triton-droids/cse-145-237d-tactile-hands/final paper/main.tex

\documentclass[acmlarge,screen,nonacm]{acmart}

% --- packages not already loaded by acmart ---
\usepackage{tabularx}

% suppress the ACM reference block (also implied by nonacm)
\settopmatter{printacmref=false}
\setlength{\footskip}{12pt}

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

%=====================================================================
\begin{document}

\title{Tactile Hands: A Force-Sensing Robotic Hand for Safe Grasping}

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

\renewcommand{\shortauthors}{Triton Droids: Tactile Hands}

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

\keywords{tactile sensing, force-sensing resistors, robotic hand, grasping,
calibration, teleoperation, ROS~2, low-cost robotics}

\maketitle

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

Why is this capability missing at low cost? High-fidelity tactile sensors are
expensive (Section~\ref{sec:related}), whereas force-sensing resistors (FSRs)
cost a few dollars each, need a single analog channel, and add no per-finger
compute. Their drawback is
signal quality: FSRs are nonlinear, hysteretic, and vary unit to unit, so a raw
reading is not a force. We treated this as an engineering problem rather than a
fundamental limit. With a controlled calibration procedure and a simple
per-sensor model, inexpensive FSRs can be made accurate enough (better than
1~N) to close a useful safety loop, which is all that grasping a fragile object
without crushing it actually requires.

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

Beyond the core force-sensing minimum viable product (MVP), we built three
input and simulation extensions that share the same ROS~2 backbone: a
webcam-based hand-pose pipeline that mirrors a human operator's finger curl onto
the hand, a physics simulation of the AmazingHand for kinematics validation and
future sim-to-real work, and a virtual-reality (VR) teleoperation pipeline that
streams 6-DoF controller pose into ROS~2. Most recently, we mounted the hand on
an open-source ARCTOS robotic arm~\cite{arctos2024} and teleoperated its
end-effector from VR controllers (Section~\ref{sec:teleopgrasp}). We
further added vision-guided, multi-object grip selection: a fine-tuned YOLO26
object detector recognizes the target object in a webcam image and selects an
appropriate per-object grip force automatically.

\paragraph{Contributions.} This paper makes the following contributions:
\begin{itemize}
  \item A \textbf{sub-\$200, open hardware design} that adds fingertip force
        sensing to a low-cost, 3D-printable robotic hand, including a custom
        ESP32-S3 sensing board with per-channel voltage dividers.
  \item A \textbf{repeatable FSR calibration procedure} using stacked 3D-printed
        reference weights and a power-law fit that maps raw ADC counts to force
        with better-than-1~N accuracy (max error 25.7~g $\approx$ 0.25~N).
  \item A \textbf{force-aware grasp controller} on a ROS~2 host that fuses the
        calibrated fingertip forces with finger position commands to grasp and
        release a fragile object without crushing it.
  \item A \textbf{teleoperation demonstration of the force-aware safety}: using VR control of the arm-mounted hand, force-thresholded
        grasping holds a fragile cup that an otherwise-identical force-blind
        grasp visibly collapses, showing the contribution of the tactile
        feedback.
  \item A set of \textbf{teleoperation and simulation extensions}
        (webcam hand-pose mirroring, physics simulation, and VR controller
        streaming) that share one ROS~2 interface, culminating in a
        VR-teleoperated, arm-mounted hand and a vision-guided, multi-object
        grip-selection pipeline driven by a fine-tuned YOLO26 detector.
\end{itemize}

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

%=====================================================================
\section{Technical Material}
\label{sec:technical}
%=====================================================================

\subsection{System Architecture}
The system is a sensing-and-actuation hand connected to a ROS~2 host. On the
hand, an ESP32-S3 reads four FSRs through voltage dividers and streams
calibrated forces over USB; on the host, a serial-bridge node publishes those
forces and forwards servo commands back. Every input subsystem (hand-pose
estimation, VR streaming, simulation) produces target finger or end-effector
commands, and the force-aware grasp controller decides to allow commanded
motion only while fingertip forces stay below a safe limit
(Figure~\ref{fig:block}).

\begin{figure}[htbp]
\centering

\caption{Force-aware grasp control loop. Target finger positions and live FSR
forces are constantly compared. If a finger's force exceeds the threshold,
motion is restricted and a red status LED lights; otherwise the servo command
is issued.}
\label{fig:block}
\end{figure}

\subsection{Mechanical Platform}
The hand is based on the open-source AmazingHand~\cite{pollen2025amazinghand}, a
four-fingered, fully 3D-printed design. Each finger is actuated by two Feetech
SCS0009 serial-bus micro servos (eight in total), giving four independently
controllable fingers.
We kept the original four-finger morphology, which is sufficient for force-aware
power and pinch grasps on our test objects and keeps the hand compact enough to
mount on a small arm. The fingertips were modified to host an FSR pad and to
route its leads back toward the palm (Figure~\ref{fig:mvphand}, left). The entire hand,
prototype board, and status LEDs are enclosed in a 3D-printed shell printed on
a Bambu Lab A1~Mini, with the electronics mounted on the back of the hand
(Figure~\ref{fig:enclosure}).

\begin{figure}[htbp]
\centering
\hspace{0.03\linewidth}

\caption{The Tactile Hand. Left: assembled on its base, with a force-sensing
resistor bonded to each fingertip and its leads routed back toward the palm.
Right: performing a force-aware grasp of a thin-walled cup, halting finger
closure the moment the measured fingertip force exceeds the safe threshold
(Section~\ref{sec:graspctl}).}
\label{fig:mvphand}
\end{figure}

\subsection{Sensing Electronics}
Each fingertip carries a Pololu \#2728 FSR. Because an FSR behaves as a
force-dependent variable resistor, we read it with a simple voltage divider: the
FSR is placed in series with a fixed reference resistor $R_\mathrm{ref}=48\,
\mathrm{k}\Omega$, and the ESP32-S3's 12-bit ADC samples the divider's midpoint,
$V_\mathrm{adc} = V_\mathrm{cc}\,R_\mathrm{ref}/(R_\mathrm{FSR}(F) +
R_\mathrm{ref})$. As applied force $F$ increases, $R_\mathrm{FSR}$ falls and
$V_\mathrm{adc}$ rises toward $V_\mathrm{cc}$; the ADC reports a raw count
$r \in [0, 4095]$. We use the ESP32-S3 for sending the data back to the host. The board is a protoboard hosting the
ESP32-S3, the four voltage dividers, and vertical 0.1-inch (2.54~mm) headers
for the FSR Dupont leads. Power comes from a 2S LiPo (7.4~V nominal) stepped
down to 5~V by a buck converter.

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

\begin{figure}[htbp]
\centering

\caption{Force-sensor calibration. Left: the calibration rig, a 3D-printed
loading plate on the FSR's active area loaded with stacked PLA reference weights
to apply a known mass. Right: a power-law model fit to seven stacked-weight
loading points maps raw ADC counts to applied force, with worst-case error
25.7~g ($\approx$0.25~N), well within the 1~N target.}
\label{fig:calib}
\end{figure}

\subsection{Force-Aware Grasp Control}
\label{sec:graspctl}
The grasp controller (Figure~\ref{fig:block}) runs on the host at the sensor
rate. A finger is driven toward a target curl by an open-loop closing
trajectory (during MVP demos) or by a teleoperation input. At every cycle the
controller reads that finger's calibrated force from \texttt{/tactile/forces}.
While the force is below the safe threshold $\tau$, the commanded position is
forwarded to the servo and the finger continues to close. The instant the force
crosses $\tau$, the controller freezes that finger's target (the ``restrict
motion'' branch) so it stops squeezing harder even though the nominal trajectory would
keep closing, and a red status LED (one of two indicator LEDs on the board)
lights to signal that the threshold has been reached. Release is triggered on
demand by commanding the fingers open. In practice this lets the hand wrap a
thin-walled paper cup and halt at its safe limit without buckling the wall
(Figure~\ref{fig:mvphand}, right).

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

\subsection{Physics Simulation}
\label{sec:simsec}
We brought up the AmazingHand in the MuJoCo physics
simulator~\cite{todorov2012mujoco} by loading its
URDF/MJCF model and verifying that the simulated finger kinematics and curl
poses match the real hand. The simulation serves two
purposes: it is a safe sandbox for validating control logic before running it on
hardware, and it is the foundation for sim-to-real experiments. The main one is an
in-hand cube-rotation policy trained in simulation that we intend to
transfer to the real hand (Figure~\ref{fig:siminhand}, left), where the reality
gap~\cite{zhao2020sim2real} between simulated and physical FSR contact remains
the central challenge.

\begin{figure}[htbp]
\centering
\hspace{0.03\linewidth}

\caption{Left: simulated in-hand manipulation. The AmazingHand model grasps a
cube in MuJoCo, the environment used to develop the in-hand cube-rotation policy
we intend to transfer to hardware. Right: vision-guided grip selection. A
fine-tuned YOLO26 detector recognizes each object and its class (e.g., filled
vs.\ empty plastic bottle), and the detected class selects a per-object
grip-force threshold the force-aware loop enforces (Section~\ref{sec:multiobject}).}
\label{fig:siminhand}
\end{figure}

\subsection{VR Teleoperation and Arm Integration}
\label{sec:vr}
Our final input modality is VR teleoperation. We initially built a Meta Quest~2
APK in Unity 2022.3 LTS from the
\texttt{unity\_ros\_teleoperation} framework~\cite{leggedrobotics_teleop} and
successfully streamed 6-DoF controller pose (position and orientation) into
ROS~2 on Ubuntu. While functional, the Quest~2 path was awkward to integrate
with our Python-based control stack. We therefore switched to Valve
Index controllers, read through OpenVR/\texttt{pyopenvr}~\cite{valve2024openvr},
which gave us a clean pure-Python interface and native per-finger capacitive
tracking. With the Index controllers, controller pose is published as a ROS~2
topic at interactive rates. The same per-finger capacitive sensing lets the
operator's finger motion drive the hand's fingers directly
(Figure~\ref{fig:vrindex}, left), so a single controller supplies both the 6-DoF wrist
pose and a per-finger curl signal on the shared \texttt{/servo/commands}
interface.

\begin{figure}[htbp]
\centering
\hspace{0.02\linewidth}%

\caption{VR teleoperation. Left: the Valve Index controller's native capacitive
finger tracking is streamed over ROS~2 to drive the robotic hand's finger curl
directly from the operator's hand. Right: the controller's 6-DoF pose drives the
ARCTOS arm end-effector through our framework (frame calibration, IK, and motion
smoothing), giving VR control of the arm-mounted hand.}
\label{fig:vrindex}
\end{figure}

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

Our pipeline recognizes the target in a webcam frame with a fine-tuned
YOLO26 object detector~\cite{ultralytics_yolo26}. We annotated a small custom
dataset of our objects (e.g., filled plastic bottle, empty plastic
bottle, plastic box container, and book) and fine-tuned YOLO26 on
it, giving real-time bounding-box detections with a class label per object
(Figure~\ref{fig:siminhand}, right). Each class maps to a hand-tuned target grip
force, with heavier or sturdier objects getting a firmer threshold and lighter or
more fragile ones a gentler threshold, and the detected class selects which
threshold the force-aware loop enforces. The detector changes only the
source of the target force; the downstream \texttt{/tactile/forces}
feedback path and the restrict-motion logic of Section~\ref{sec:graspctl} are
reused unchanged, which kept the addition lightweight.

This experiment also exposes a calibration limitation: FSRs respond differently
to off-axis and shear loading than to the normal loading used during calibration
(Section~\ref{sec:calibration}), so a misaligned grip reads a biased force. We
have begun characterizing each sensor's off-axis response and feeding it back
into the physics simulation (Section~\ref{sec:simsec}) to tighten the sim-to-real
match.

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

\begin{table}[t]
\caption{Milestone status. All MVP-track items are complete; reach goals range
from complete to not completed, consistent with their deferred priority.}
\label{tab:milestones}
\small
\renewcommand{\arraystretch}{1.05}
\begin{tabularx}{\linewidth}{@{}Xll@{}}
\toprule
\textbf{Milestone} & \textbf{Target} & \textbf{Status} \\
\midrule
System design, board fabrication \& components & W2--W4 & Complete \\
Hand assembly, FSR integration \& firmware     & W3--W5 & Complete \\
FSR calibration to within 1~N                  & W4--W6 & Complete \\
Simulation bring-up of AmazingHand             & W3--W5 & Complete \\
Force-aware grasping closed loop               & W5--W6 & Complete \\
\textbf{MVP completion \& validation}          & \textbf{W6} & \textbf{Complete} \\
Hand-pose estimation pipeline (reach)          & W7--W9 & Complete \\
VR teleoperation: pose streaming, arm integration \& force-aware grasp (reach) & W7--W9 & Complete \\
Multi-object force awareness (reach)           & W8--W9 & Complete \\
Sim-to-real in-hand rotation (reach)           & W8--W9 & Not completed \\
Final paper, demo video, GitHub repo           & W9--W10 & In progress \\
\bottomrule
\end{tabularx}
\end{table}

\subsection{Mid-Quarter Revisions}
Our main mid-quarter revision was the VR hardware: we changed from the chartered
Meta Quest~2 to Valve Index controllers (Section~\ref{sec:vr}). We had a working
Quest~2 APK, but it was awkward to drive from our Python stack.

\subsection{What We Did and Did Not Finish}
All MVP deliverables were met, and the reach-goal outcomes are listed in
Table~\ref{tab:milestones}. Two items remain unfinished: the sim-to-real
transfer of the in-hand rotation policy (trained in simulation but not yet moved to hardware),
and finger adduction/abduction control (our curl interface captures flexion
only). Because reach goals were started only after the
Week~6 MVP, these gaps reflect the time available afterward, not a failure of the
core deliverable.

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

%=====================================================================
\bibliographystyle{ACM-Reference-Format}
\bibliography{references}

\end{document}
