triton-droids/cse-145-237d-tactile-hands/final paper/figures/arm_mounted.png

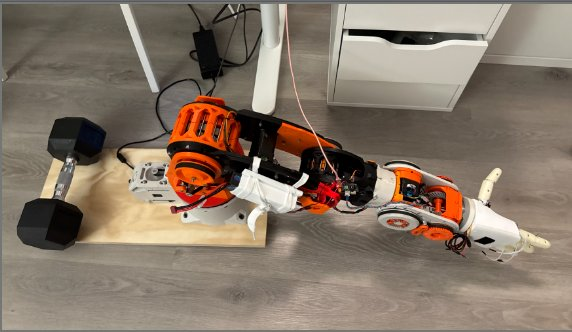
final paper/figures/arm_mounted.png
