triton-droids/cse-145-237d-tactile-hands/final paper/figures/open_hand.png

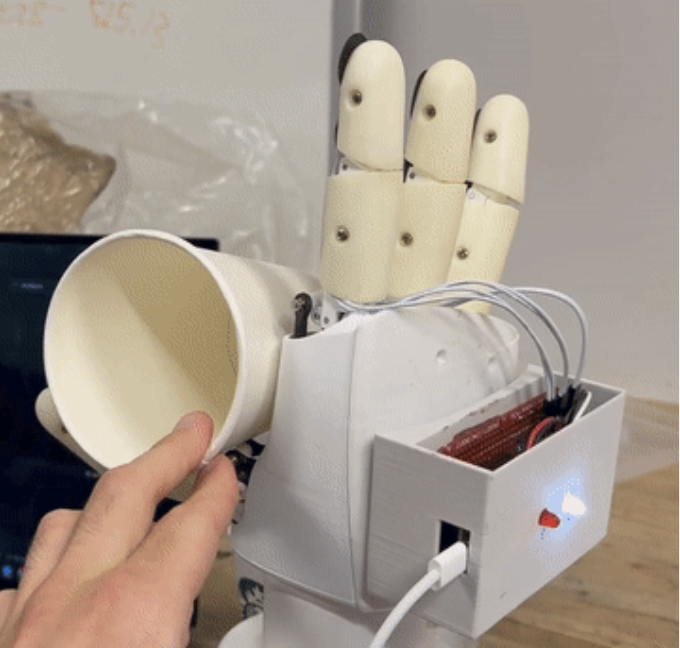
final paper/figures/open_hand.png
