triton-droids/cse-145-237d-tactile-hands/final paper/figures/sim.png

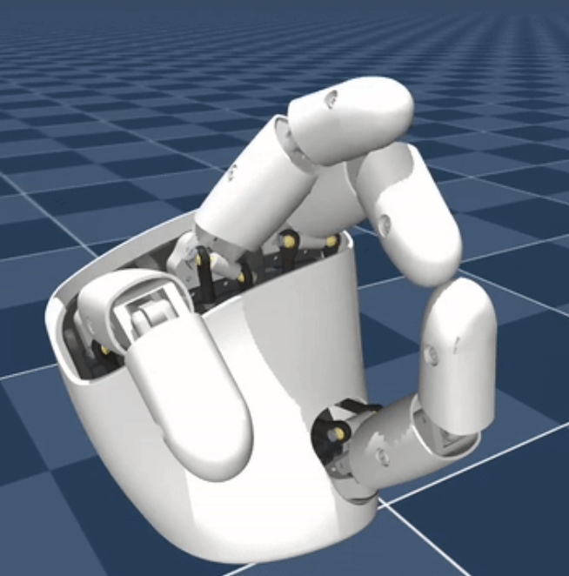
final paper/figures/sim.png
