triton-droids/cse-145-237d-tactile-hands/final paper/figures/teleop_noforce.png

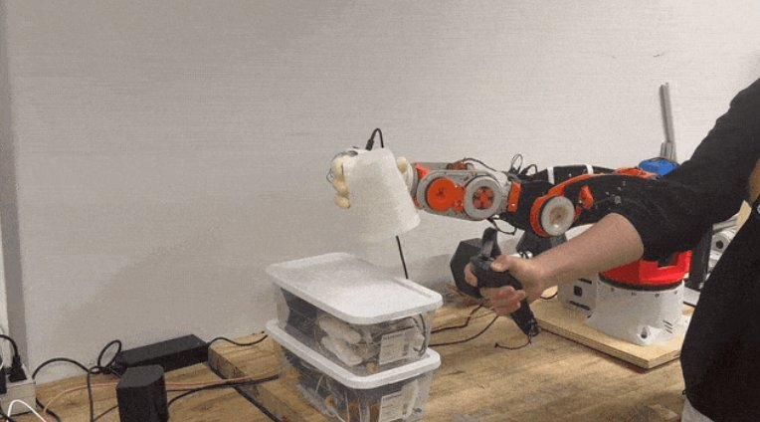
final paper/figures/teleop_noforce.png
