triton-droids/cse-145-237d-tactile-hands/hand_control/Mediapipe hand model.png

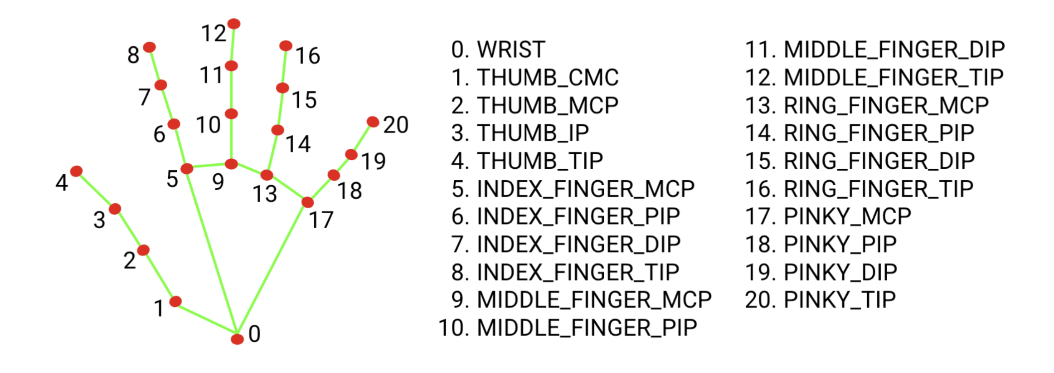
hand_control/Mediapipe hand model.png
