triton-droids/cse-145-237d-tactile-hands/fsr_calibration/FSR Calibration Plate.stl

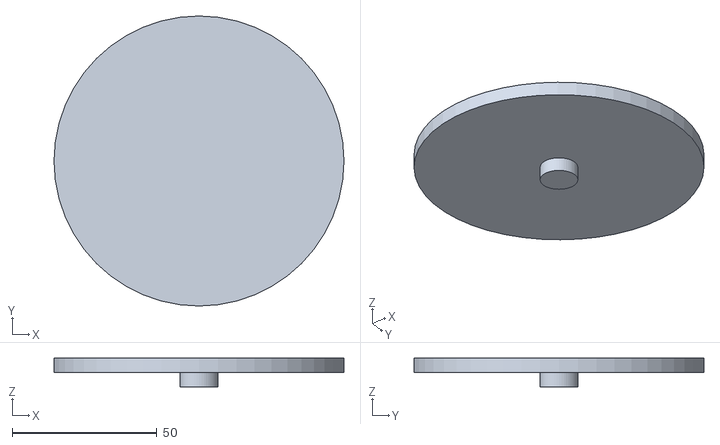
[picture p30: CAD file, 2026-05-09]
fsr_calibration/FSR Calibration Plate.stl
100.0 x 100.0 x 10.0
