triton-droids/cse-145-237d-tactile-hands/fsr_calibration/fsr_calibration.png

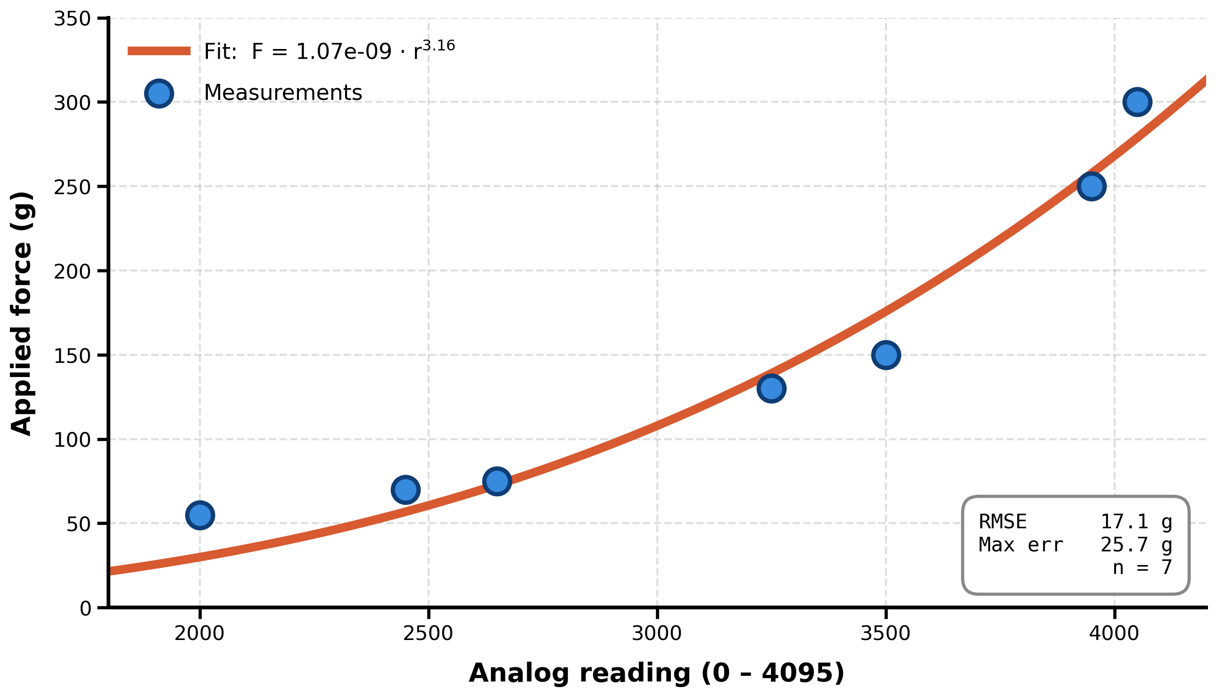
fsr_calibration/fsr_calibration.png
