triton-droids/cse-145-237d-tactile-hands/(commit log)

2026-05-04 force calibration slide
2026-05-09 Upload calibration plate
    [FSR Calibration Plate.stl]
2026-05-18 Add VR rotation teleop for ARCTOS J1 (velocity mode)
    - arctos_arm.py: add speed-mode primitive (0xF6) set_joint_speed/
    stop_joint; settle delay + retrying sync_all_encoders to fix
    first-frame-drop on connect; port autodetect skips legacy ttyS*
    and Valve/Watchman VR devices.
    - vr_teleop_rotation.py: deadman (hold-B) clutch; controller yaw
    offset from clutch-in -> J1 joint speed; open-loop + encoder-poll
    travel limit; graceful stop on release/exit.
    - teleop_actions.json / teleop_binding.json: minimal Index binding
    (hand_pose + clutch on B), no calibration.
    Hardware-verified on J1: connect, speed mode, direction, stop.
    [arctos_arm.py, vr_teleop_rotation.py]
2026-05-18 Switch VR teleop to position control (P-loop on speed mode)
    Controller yaw offset from clutch-in now maps to a J1 *target angle*
    (SCALE, default 1:1) instead of a speed. Implemented as a software
    P-loop on the hardware-verified 0xF6 speed mode: rpm = KP*(target -
    encoder), capped; settles in POS_DEADBAND_DEG. No 0xFE needed.
    Encoder feedback is now required — loop commands 0 if samples go
    stale (ENC_STALE_S) rather than drive blind. Faster encoder poll
    (0.08s). Target clamped to +/-MAX_TRAVEL_DEG of engage; hard runaway
    guard locks out if measured angle overshoots clamp + margin.
    Hardware-verified on J1: servos to +/-5 deg targets and back,
    settles within deadband, no overshoot.
    Co-Auth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
    [vr_teleop_rotation.py]
2026-05-18 Add J2 (shoulder) axis: controller vertical -> J2 position
    - Two-axis position teleop: J1<-controller yaw, J2<-controller
    height (room +Y). Generic per-axis config; encoder poller and
    P-loop now handle N joints; pose includes translation.
    - Per-joint rpm_floor + pos_deadband. J2 (loaded shoulder) has
    ~40 rpm break-away; KP*err alone stalls short of target, so
    nonzero commands are floored to rpm_floor (J2=45, J1=8).
    - Same B deadman clutch; engage refused unless ALL joints have a
    fresh encoder; runaway guard stops all joints.
    Hardware-verified J2: +rpm increases encoder (sign matches J1),
    P-loop converges to multiple targets both directions with no
    stall (residual within deadband).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
    [vr_teleop_rotation.py]
2026-05-18 Restructure VR teleop around a ROS publisher
    One OpenVR client (vr_controller_publisher.py) publishes the right
    controller pose + clutch on /vr/right_controller/pose (PoseStamped)
    and /vr/clutch (Bool). Teleop and visualizer are now ROS subscribers
    — no more dual-OpenVR concern.
    - vr_ros_io.py: shared transport + pose math + the AXES map (single
    source of truth). No openvr/python-can deps, so the visualizer
    stays arm-free. quat<->mat verified lossless; staleness tracking.
    - vr_teleop_rotation.py: drops OpenVR; consumes ROS; stale pose/
    clutch (publisher died / controller dropped) -> command 0.
    - vr_visualizer.py: consumes ROS instead of its own OpenVR.
    - run_vr_teleop.sh: sources RO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
2026-05-18 Fix: Ctrl+C ignored under ROS (arm + port left stuck)
    rclpy + the DDS layer install a SIGINT handler that swallowed Ctrl+C,
    so the teleop's finally never ran: arm not stopped, /dev/ttyACM0 left
    locked, process unkillable without SIGKILL. rclpy SignalHandlerOptions.NO
    alone was not enough (DDS still grabs it).
    - vr_ros_io: ros_init_no_signals(); ControllerSubscriber re-claims
    SIGINT+SIGTERM AFTER rclpy/DDS init (so ours wins), both raise
    KeyboardInterrupt into the main thread. Bounded executor shutdown
    so teardown can't hang.
    - publisher uses ros_init_no_signals() too.
    - teleop drops its now-redundant SIGTERM block.
    Verified: SIGINT and SIGTERM both -> clean exit ~0s with the
    subscrib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
    [vr_controller_publisher.py, vr_ros_io.py, vr_teleop_rotation.py]
2026-05-18 Faster 3D viz: persistent artists, FPS, axis swap
    - run_3d no longer ax.cla()+replot every frame. Artists created
    once; data updated via set_data/set_3d_properties. Recenter only
    near the cube edge (constant autoscale was the main slowdown).
    - --fps flag (default 30); live FPS shown in the info panel.
    - Backend guard: warn + fall back to text if matplotlib is on a
    non-interactive Agg backend (no window). Needs PyQt6 -> QtAgg.
    - Swap room Y<->Z in the plot so room-up (Y) is the vertical axis;
    labels/limits updated. Was confusing before.
    [vr_visualizer.py]
2026-05-18 Viz: fall back to text if Qt backend fails to start
    PyQt6 6.5+ needs system libxcb-cursor0 or the xcb plugin aborts the
    process. Realize the canvas early inside try/except and degrade to
    text mode with a clear apt hint instead of crashing the viz while
    teleop/publisher keep running.
    (install_vr_ros_deps.sh now apt-installs libxcb-cursor0 too.)
    [vr_visualizer.py]
2026-05-18 Fix yaw wrap discontinuity (atan2 +/-180 boundary)
    controller_yaw_deg wraps at +/-180; raw (yaw - yaw_ref) jumped ~360
    when crossing it, which the J1 P-loop turned into a slam. Add
    source_offset(): shortest signed difference for angular sources
    (SRC_WRAP), plain subtraction for linear (height). Used by teleop
    and visualizer so displayed target == commanded target.
    Verified: off(-179,179)=+2 (was -358); linear unchanged.
    [vr_ros_io.py, vr_teleop_rotation.py, vr_visualizer.py]
2026-05-18 Add One-Euro filter on the yaw source
    Yaw tracking had ~2deg jitter. Add a per-axis One-Euro filter
    (SourceFilter) on a continuous unwrapped signal so the +/-180 seam
    never enters the filter. Enabled for yaw (J1), off for height (J2).
    Filter runs every tick so it is warm at clutch-in; reference and
    live value both filtered -> no engage step.
    Sim (50Hz, +/-2deg noise): rest jitter 1.92->0.70 deg; during a
    30deg/s sweep noise 1.86->0.36 deg at ~89ms lag. Tunable via
    YAW_FILTER (mincutoff/beta).
    [vr_ros_io.py, vr_teleop_rotation.py]
2026-05-18 Publish Valve Index finger curls + trigger + grip
    Bring the capacitive finger-sensing path from the MuJoCo teleop into
    the ROS architecture so the AmazingHand driver can subscribe.
    - teleop_actions/binding.json: add skeleton_right (skeleton),
    trigger, grip actions + knuckles bindings.
    - publisher: read skeletal summary (VRSummaryType_FromAnimation),
    trigger, grip each tick; publish /vr/finger_curls
    (Float32MultiArray[5], FINGER_ORDER thumb,index,middle,ring,
    pinky; 0=open 1=closed), /vr/trigger, /vr/grip (Float32).
    Skeleton-missing fallback: curls = clip(trig + 0.5*grip), same
    as the MuJoCo teleop.
    - vr_ros_io: topic + FINGER_ORDER constants; HandSubscriber
    (background spin, s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
    [vr_controller_publisher.py, vr_ros_io.py]
2026-05-18 Port resolver: deterministically prefer the CANable
    The AmazingHand servo adapter (QinHeng 1A86 USB-serial) now shares the
    bus. Auto-detect took the first VID'd port, so it could grab the hand's
    tty for the arm (enumeration order is unstable). Add a CANable
    preference (VID 16D0 or canable/slcan/cantact/gs_usb in the descriptor)
    chosen ahead of any other usable port; warn + fall back otherwise.
    Verified with both plugged in: resolves /dev/ttyACM0 (CANable),
    skips /dev/ttyACM1 (hand).
    [arctos_arm.py]
2026-05-18 Add AmazingHand control node (ROS finger curls -> SCS servos)
    vr_hand_control.py: subscribes HandSubscriber, EMA-smooths the 5
    curls, maps to the 8 AmazingHand servos with the demo's differential
    open(-35/+35)/close(+90/-90) angles + per-servo MiddlePos, drives
    them via rustypot.
    Safety: DRY by default (subscribe + print targets, no torque/writes);
    --live refused unless HAND_CALIBRATED; stale finger data -> hold last
    goal; Ctrl+C -> open then torque-off. Servo bus auto-targets
    /dev/ttyACM1 (the QinHeng adapter, distinct from the CANable).
    Verified offline: mapping math == AmazingHand_Demo; DRY end-to-end
    with synthetic feed tracks + stale-holds; servos ping/read on
    /dev/ttyACM1 (torque off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
2026-05-18 Set AmazingHand calibration from hand_control/angle_control.py
    HAND_MIDDLE_POS = this hand's real calibration
    ([1.4,19.6,12.6,-7.9,13.9,10.5,17,-28.1]); same MiddlePos[ID-1]+angle
    formula and servo-id pairs as the project's existing hand code.
    HAND_CALIBRATED=True so --live is now permitted. Computed close
    angles for servos 1-6 match the limp hand's measured rest positions
    (sanity check passed).
2026-05-18 Launcher: add --hand (AmazingHand --live)
    run_vr_teleop.sh --hand also starts vr_hand_control.py --live.
    Teardown now SIGINTs teleop AND hand in parallel, each given ~5s
    for its finally (teleop: stop arm + free CAN port; hand: open +
    torque off), before tearing down viz/publisher.
2026-05-18 Add cleanup.sh — kill orphaned VR-teleop processes
    After a failed Ctrl+C the publisher (no SIGINT reclaim) and others
    can linger and hold /dev/ttyACM0|1. cleanup.sh finds them by script
    name, SIGINT (arm stop / hand open) then SIGKILL fallback, and
    reports/frees both serial ports. Found and cleared 2 real orphans
    on first run.
2026-05-18 Add 6-DOF controller calibration (Beat-Saber style)
    Hold A with the controller aligned to your forearm: publisher
    averages ~1s of pose, saves R_cal/p_cal to vr_calibration.json
    (atomic, persists across runs), and re-expresses every published
    pose in that neutral frame (p'=R_cal^T(p-p_cal), R'=R_cal^T R).
    Consumers unchanged — yaw/roll/height/XYZ become arm-relative and
    decouple. Identity calibration = no-op, so uncalibrated still works.
    vr_ros_io: load/save_calibration, average_rotations (SVD mean),
    apply_calibration. teleop_actions/binding: A -> calibrate action.
    Verified offline: save/load exact; neutral pose -> origin/identity
    (yaw/roll/height = 0); no-file -> identity.
    NOTE: also sna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
    [vr_controller_publisher.py, vr_ros_io.py]
2026-05-18 Make J2/J3 max_travel=1000 permanent (de-TEMP)
    Per user: the large soft-travel clamp on J2/J3 is intentional, not
    a temporary tuning step. Reworded the comments accordingly; values
    unchanged. Soft clamp + runaway guard remain effectively off on
    J2/J3 by design — deadman clutch + max_rpm + staleness stop are the
    active safeties there.
2026-05-18 Calibration: rotation-only transform
    apply_calibration now re-expresses orientation only (R'=R_cal^T R);
    position passes through unchanged. Height (J2/J3) stays world-
    vertical and the deadman clutch already re-zeros position per
    engage, so a position offset added nothing. p_cal still captured/
    stored (stable schema) but unused. Neutral-pose still -> yaw/roll 0.
2026-05-18 Make teardown atomic vs a second signal
    A 2nd SIGINT/SIGTERM during cleanup (re-press, or launcher SIGINT
    then SIGKILL) re-raised KeyboardInterrupt through the finally —
    BaseException, so it bypassed `except Exception` in shutdown() and
    could skip stopping the arm / freeing the CAN port (the reported
    traceback). Add disarm_term_signals() (SIG_IGN on SIGINT+SIGTERM),
    called as the first line of every finally (teleop/hand/viz) and
    defensively atop both subscribers' shutdown(). First signal still
    breaks the loop; launcher SIGKILL remains the backstop.
    Verified: SIGINT+SIGTERM fired mid-cleanup -> cleanup still runs to
    completion and the process exits.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
    [vr_hand_control.py, vr_ros_io.py, vr_teleop_rotation.py, vr_visualizer.py]
2026-05-20 Launcher: default everything; --no-* opts out; fix cleanup deadlock
    Stack defaults: publisher + teleop + visualizer + calibration sliders
    + AmazingHand. Opt out individually with --no-viz / --no-cal / --no-hand.
    The old --viz/--cal/--hand flags are removed (rejected as unknown).
    Fix a wedge in cleanup(): the bare `wait` blocked on EVERY background
    job of the launcher shell, which includes PUB/VIZ/CAL/HAND. With viz
    unable to self-exit on SIGINT (Qt-swallows KeyboardInterrupt; fixed
    separately), `wait` never returned and the kill -INT/-9 lines for the
    data sources were never reached -- so processes appeared to "not die".
    Capture the two graceful subshell PIDs explicitly and wait only on
    them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
2026-05-20 Publisher: drop A-button capture; hot-reload calibration from file
    The 6-DOF calibration is now set entirely from vr_calibration_gui.py
    (sliders / +-/ typable boxes / gesture capture). The publisher no
    longer listens to the A "calibrate" action -- it just loads the JSON
    on start and reloads it whenever the file mtime changes, so any
    slider tweak applies live without a restart. All-zero calibration is
    a no-op (raw room frame).
2026-05-20 Add vr_calibration_gui: 6-DOF sliders + gesture capture
    Window with 6 rows (X Y Z metres, Roll Pitch Yaw degrees), each with a
    slider + "-"/"+" nudge + typable value box. Every change is written
    atomically to vr_calibration.json; the publisher hot-reloads on mtime
    change, so robot frame updates live.
    Gesture auto-calibration (orientation only):
    * Capture FWD -- point the controller forward, click.
    * Capture UP -- point it up, click.
    The GUI averages the pointing axis (R @ [0,0,-1]) over ~0.5 s per
    capture, then Gram-Schmidt fits a frame where FWD -> -Z, UP -> +Y,
    converts R_cal to RPY, and writes it into the sliders. X/Y/Z stay 0.
    Rejects near-parallel captures with a clear message.
    R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
2026-05-20 vr_ros_io: 6-DOF calibration model, RPY helpers, gesture solver, J4 off
    Calibration
    -----------
    Replace the rotation-only A-capture model with a human-readable 6-DOF
    transform (x,y,z metres + roll_deg, pitch_deg, yaw_deg). Persisted as
    a 6-key JSON that's hand-editable. apply_calibration does
    R_aligned = R_cal^T R
    p_aligned = R_cal^T (p - t)
    with R_cal = Rz(yaw) Ry(pitch) Rx(roll). All-zero = identity no-op.
    Drop average_rotations (unused now); add euler_to_mat, mat_to_euler
    (its exact inverse, with pitch=+-90 gimbal handling), cal_to_mats,
    load_cal_params, save_cal_params (atomic).
    Gesture calibration
    -------------------
    Add gesture_calibration(fwd_dir, up_dir) that fits a frame where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
    [vr_ros_io.py]
2026-05-20 Visualizer: cooperative SIGINT, triad legend, RPY readout
    Cooperative SIGINT
    ------------------
    ControllerSubscriber reclaims SIGINT and *raises* KeyboardInterrupt
    at an arbitrary bytecode boundary. In this process that lands inside
    matplotlib's Qt _draw_idle, where PyQt prints the traceback but
    swallows the BaseException and keeps the event loop running -- so the
    viz never broke its loop on Ctrl+C and stayed alive (with the
    launcher then deadlocking on bare `wait`; fixed separately). Install
    a cooperative handler after the subscriber is built that just sets a
    stop flag the render loop polls -- no exception is thrown into Qt at
    all. Add os._exit(0) after the finally so the rclpy/DDS daemon-t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
    [vr_visualizer.py]
2026-05-20 Add README_vr_teleop.md
    Dedicated README for the VR teleop stack (the existing README.md
    documents arctos_arm.py only). Covers: architecture (one publisher +
    ROS-subscribing consumers), requirements, the launcher's default-
    everything / --no-* model, role of each script, JSON files (calibration
    schema + SteamVR manifest), the manual + gesture calibration workflow
    (with the gimbal-lock caveat), the joint mapping (incl. J4 disabled),
    controls, built-in safety nets, and troubleshooting drawn from the
    issues we've actually hit (stale launcher, busy ports, yaw jumps near
    vertical, the cosmetic DDS abort).
2026-05-27 teleop: drive J1 only (disable J2/J3 axes) + add --no-arm flag
    - vr_ros_io: comment out J2/J3 in AXES so the teleop drives J1 only
    (J4 was already disabled), matching the J1-only bring-up.
    - run_vr_teleop.sh: add --no-arm to run the publisher + viz/cal/hand
    without the teleop/CAN connection (useful while J1's board is down).
2026-05-28 teleop: switch driven joint to J2, skip dead J1 in encoder sync
    J1 motor board stopped answering on CAN, blocking connect() in
    sync_all_encoders(). Drive J2 from controller y instead and let
    ARCTOS_JOINTS env override the polled joint set so a single dead
    board no longer wedges startup. Also quiet per-frame CAN TX/RX
    prints behind ARCTOS_CAN_DEBUG, and report raw + ema hand curls
    once per second instead of every loop.
    [arctos_arm.py, vr_hand_control.py, vr_ros_io.py]
2026-05-28 hand: FSR force-stop + close-speed rate limit
    Reads ESP32 FSR CSV on /dev/ttyUSB0 in a background thread. If any
    of the 4 channels (thumb/index/middle/ring) exceeds FORCE_LIMIT, the
    whole hand is held at its last commanded curl until release; LED on
    the ESP32 turns red. Also caps curl increase per loop (MAX_CLOSE_STEP)
    so closing is smooth — opening stays instant.
2026-06-02 oral: replace presentation video with 720p/15fps final cut
2026-06-05 website: real teaser clip + milestone report, drop placeholders
    - replace home-page banner (old mid-quarter recording) with the teleop
    force-aware grasp clip; update caption to match
    - swap placeholder poster (sample.pdf) for the actual milestone report PDF
2026-10-02 Add ARCTOS arm tools and utilities
    - Implemented poses management in poses.py for saving, loading, and deleting joint poses with safety checks.
    - Created read_params.py to read and compare MKS servo system parameters across joints.
    - Developed read_pos.py to read joint positions without engaging motors.
    - Introduced selftest.py for offline self-testing of ARCTOS arm tools, ensuring all dependencies are met and functionality is intact.
    - Added set_params.py for writing MKS servo system parameters over CAN.
    - Created setup.sh for setting up the environment and installing necessary dependencies.
    - Developed teleop_gui.py for a teleoperation panel with live encoder readouts and emergency stop fu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
